kenhabbes-glitch/Varde/Varde-oppsett-ny-PC.docx

VARDE · PROSJEKT GPS VS TYV

# Oppsett på ny PC

Steg for steg: flytte prosjektet, installere programvare, kjøre plattformen lokalt og på Render, 3D-printe kapslingene og lage dokumentene på nytt. Oppdatert 27. oktober 2026. Skrevet for Windows 10 og 11.

# 1. Kort oppsummert

Alt du trenger ligger i Varde-prosjekt.zip. Dokumentene på claude.ai, Claude-prosjektet «GPS Vs Tyv», GitHub og Render følger kontoene dine og må ikke flyttes. Du trenger bare å logge inn på den nye PC-en.

1. Last ned Varde-prosjekt.zip og pakk den ut til C:\Varde.
2. Installer Node.js og eventuelt Python og et slicer-program (kapittel 4).
3. Åpne et terminalvindu i C:\Varde\Varde-prosjekt\kode og kjør npm test. Står det pass 23 og fail 0, er alt på plass.
4. Logg inn på claude.ai og åpne prosjektet «GPS Vs Tyv» for å fortsette arbeidet med Claude.

# 2. Innholdet i pakken

Mappen Varde-prosjekt inneholder dette:

Fil eller mappe | Innhold
LES-MEG.md | Oversikt over alle filene
GPS-Vs-Tyv-teknisk-design-v0.13.pdf | Gjeldende tekniske design, 54 sider
GPS-Vs-Tyv-elektriske-skjemaer-rev0.1.pdf | Elektriske skjemaer for alle kretskort (A3)
GPS-Vs-Tyv-simulator.html | Interaktiv demo av systemet. Åpnes i nettleser
GPS-Vs-Tyv-alarmsentral-prototype.html | Klikkbar prototype av dashboard og app
GPS-Vs-Tyv-designgrunnlag-hovedenhet-v1.docx | Første designgrunnlag. Delvis erstattet av PDF-en
kode\ | Plattform, dashboard, simulator og fastvare v0.2.1
kapslinger\ | STL-filer for 3D-print, bilder og kildekode v0.1
kilder\designdokument\ | Designdokumentet som HTML, og skript som lager PDF
kilder\skjemaer\ | Python-program som lager skjemaene
kilder\produktvisualisering\ | Kildefiler til produktvisualiseringen (referanse)
Varde-oppsett-ny-PC.docx | Denne veiledningen

Pakken inneholder ikke hemmeligheter. Plattformens nøkkel (platform-key.pem), lokale data (data.json) og tokenene til Render er holdt utenfor med vilje.

# 3. Flytte til ny PC

## Filene

1. Last ned Varde-prosjekt.zip fra Claude-samtalen.
2. Høyreklikk på filen, velg Pakk ut alle og velg C:\Varde som mål.
3. Ikke legg mappen i OneDrive. Synkroniseringen kan låse filer mens plattformen skriver til dem, og STL-filene er store.
4. Har du kjørt plattformen lokalt på den gamle PC-en og vil beholde testdataene, kopier data.json og platform-key.pem fra den gamle kodemappen til den nye. Ellers trenger du ikke dem.

## Claude-prosjektet og dokumentene

Prosjektet «GPS Vs Tyv» og alle dokumentene under ligger på claude.ai og følger kontoen din. Åpne dem fra nettleseren eller Claude-appen på den nye PC-en. Hvert dokument kan lastes ned som Word eller PDF fra dokumentets meny.

Dokument | Hva det er
Varde – oppsett av programvare (https://claude.ai/artifact/Y5VeZJ1YmCVUKAf8BAsJKU) | Den samme veiledningen som denne, i nettversjon
Varde – 3D-printede kapslinger (https://claude.ai/artifact/JtDKBCGQ6jCCAQ2TDHMq2U) | Materialer, innstillinger, montering og test av kapslingene
Varde – Adversarial Review (https://claude.ai/artifact/VaqWh7EG5VVC4pQoucCckC) | Gjennomgang av svakheter med prioritert tiltaksliste (engelsk)
Varde – produktvisualisering (https://claude.ai/artifact/XJEYnFzurU5y2nJ5eHvLHa) | Tavler med produktet, appen, geofence og navn og logo
GPS Vs Tyv – komponenter og leverandører (https://claude.ai/artifact/6AKMAZ8Rii6d945ZJGsUYA) | Komponentpriser, livsløp, CE og produsenter
GPS Vs Tyv-simulator (https://claude.ai/artifact/DBvJbYfc7tKbfaEAasuZXi) | Nettversjon av simulatoren
GPS Vs Tyv Alarmsentral (https://claude.ai/artifact/6chnuUW5rB7gucUFBs3AWz) | Nettversjon av alarmsentral-prototypen
Koplingsskjema og kretskortdesign v1 (https://claude.ai/artifact/FX7nrYhcUT3ShhFDbmn8so) | Første versjon av skjemaene (historikk)

## GitHub og Render

Har du allerede satt opp plattformen på Render, kjører den videre i skyen og trenger ikke flyttes. Logg inn på github.com og render.com på den nye PC-en. Tokenene finner du under Environment i Render-tjenesten. Har du ikke satt opp Render ennå, følg kapittel 6.

# 4. Installere programvare

Alt er gratis. Installer det du trenger for delen du skal jobbe med.

Program | Trengs for | Hent fra | Merknad
Node.js LTS (22.18 eller nyere) | Plattformen, simulatoren og å lage PDF-er | nodejs.org | Påkrevd for kode
Python 3.10 eller nyere | Endre mål på kapslinger, lage skjemaer | python.org (https://www.python.org/downloads/) | Huk av for «Add python.exe to PATH»
Bambu Studio eller PrusaSlicer | 3D-print | bambulab.com (https://bambulab.com/en/download/studio) / prusa3d.com (https://www.prusa3d.com/page/prusaslicer_424/) | Velg det som passer skriveren
Visual Studio Code | Lese og endre kode og mål | code.visualstudio.com | Valgfritt
GitHub Desktop | Laste opp endringer til GitHub | desktop.github.com | Valgfritt, enklere enn nettleseren
Claude-appen | Fortsette arbeidet med Claude | claude.ai/download | Valgfritt, nettleseren holder

Kontroller installasjonen i et nytt terminalvindu (trykk Windows-tasten, skriv cmd og trykk Enter):

node --version

npm --version

py --version

Node skal vise v22.18 eller høyere, og Python 3.10 eller høyere. Vises «gjenkjennes ikke», lukk vinduet og åpne et nytt.

# 5. Plattformen på din PC

Kjør plattformen lokalt først. Da ser du dashboardet og alarmene uten kostnad, og du vet at alt virker før det legges på nett.

1. Åpne mappen C:\Varde\Varde-prosjekt\kode i Filutforsker, skriv cmd i adressefeltet og trykk Enter.
2. Kjør testene med npm test. Nederst skal det stå pass 23 og fail 0. Det trengs ingen npm install, fordi koden ikke har tilleggspakker.
3. Start plattformen med npm run dev. Svaret er Varde-plattformen kjører på http://localhost:8080 (UTVIKLINGSMODUS ...). La vinduet stå åpent.
4. Gå til http://localhost:8080 i nettleseren. Skriv operator-dev i Token-feltet og trykk Kople til.
5. Åpne et nytt terminalvindu i samme mappe og kjør npm run sim:auto. Simulatoren spiller av åtte scenarioer, og til slutt står det Alle kontroller bestått. Alarmene vises i dashboardet underveis.
6. Kjør npm run sim for den interaktive simulatoren. Skriv hjelp for å se kommandoene.
7. Stopp med Ctrl+C i begge vinduene.

Utviklingsmodus bruker de faste tokenene admin-dev og operator-dev og er bare for din egen PC. npm start (driftsmodus) starter ikke uten egne token.

## Fastvaretester (valgfritt)

Fastvaretestene trenger en C-kompilator. Den enkleste veien på Windows er WSL med Ubuntu: kjør wsl --install i PowerShell som administrator, start PC-en på nytt, og kjør deretter sudo apt install build-essential i Ubuntu. Gå til kodemappen (cd /mnt/c/Varde/Varde-prosjekt/kode) og kjør make -C firmware/hovedenhet/test. Det skal stå 198 av 198 kontroller bestått.

# 6. Plattformen på nett (Render)

Plattformen må kjøre hele tiden, ellers merker den ikke at en maskin har blitt stille. Gratisvarianten hos Render sover etter 15 minutter uten trafikk og kan ikke ha disk, så den passer ikke. Velg instanstypen Starter med disk. Den koster rundt 7 USD i måneden, og disken 0,25 USD per GB i måneden. Sjekk gjeldende pris på render.com.

## Legg koden på GitHub

1. Logg inn på github.com og velg New repository. Gi det navnet varde og velg Private.
2. Velg uploading an existing file og dra inn alt innholdet i mappen kode, også mappen .github. Med GitHub Desktop: velg Add existing repository, pek på kodemappen og trykk Publish repository med Keep this code private på.
3. Ikke last opp data.json eller platform-key.pem hvis de finnes.
4. Trykk Commit changes. Under fanen Actions kjører testene automatisk og skal bli grønne.

## Opprett tjenesten hos Render

1. Logg inn på render.com med GitHub-kontoen og velg New → Web Service. Gi Render tilgang til repoet varde og velg det.
2. Velg Language: Docker, region Frankfurt (EU Central) og instanstype Starter.
3. Under Environment Variables legger du inn GVT_ADMIN_TOKEN og GVT_OPERATOR_TOKEN. Trykk Generate for hver av dem. Plattformen starter ikke uten dem, og de må være minst 32 tegn.
4. Under Advanced → Disk velger du Add disk med mount path /data og størrelse 1 GB.
5. Sett Health Check Path til /api/health.
6. Trykk Deploy Web Service. Etter et par minutter skal loggen vise Varde-plattformen kjører på ....

## Test at den virker

1. Åpne adressen Render viser, for eksempel https://varde-xxxx.onrender.com.
2. Kopier verdien av GVT_OPERATOR_TOKEN fra Render, lim den inn i Token-feltet og trykk Kople til.
3. Kjør simulatoren mot nettversjonen fra kodemappen, med dine egne verdier:

set GVT_URL=https://varde-xxxx.onrender.com

set GVT_ADMIN_TOKEN=<admin-token fra Render>

set GVT_OPERATOR_TOKEN=<operatør-token fra Render>

npm run sim:auto

I PowerShell skrives det $env:GVT_URL="https://..." i stedet for set. Nye versjoner rulles ut automatisk når du laster opp endringer til GitHub. Del bare operatør-tokenet med dem som skal følge alarmene.

# 7. 3D-print og nye dokumenter

## Printe kapslingene

1. Åpne Bambu Studio eller PrusaSlicer og velg skrivermodellen.
2. Dra en STL-fil fra kapslinger\stl inn i programmet, for eksempel varde-hovedenhet-bunn-prototype.stl. Delen ligger allerede riktig vei.
3. Velg PETG for prototype og ASA for felt. Bruk innstillingene i dokumentet «Varde – 3D-printede kapslinger»: 0,2 mm lag, 3 vegger og 25 % gyroid (PETG), eller 5 vegger og 40 % gyroid (ASA). Ingen støtte.
4. Trykk Slice, kontroller lagene og print. Print bunn og lokk av hovedenheten i PETG først for å teste passform.
5. Uten egen skriver: bestill feltvarianten i SLS PA12, svart, med impregnering hos et printverksted.

## Endre mål og lage nye STL-filer

Åpne et terminalvindu i kapslinger\kilde. Endre mål i varde_kapsling.py (søk etter SJEKK), og lag filene på nytt:

py varde_kapsling.py

py varde_kapsling.py hovedenhet

py meshcheck.py stl\*.stl

Den første kommandoen lager alle enhetene og den andre bare én. Den tredje kontrollerer filene: tallet i midten skal være 0. Nye filer havner i kapslinger\kilde\stl.

## Lage designdokumentet og skjemaene på nytt

Dette trengs bare hvis du endrer kildefilene. Begge bruker nettleseren Chromium via Playwright, som installeres én gang i mappen kilder:

cd C:\Varde\Varde-prosjekt\kilder

npm init -y

npm install playwright

npx playwright install chromium

Designdokumentet: endre designdokument\design.html og kjør node lag-pdf.js i den mappen. Resultatet blir out.pdf.

Skjemaene: kjør py build.py i skjemaer. Det lager schem.html og skriver ut eventuelle nett med bare én tilkobling, som er forventet for ubrukte innganger. Kjør så node pdf.js for å lage schem.pdf.

Produktvisualiseringen redigeres på claude.ai. Filene i kilder\produktvisualisering er en sikkerhetskopi av tavlene.

# 8. Feilsøking

Melding eller symptom | Årsak | Løsning
Unknown file extension ".ts" | Node er eldre enn 22.18 | Installer siste LTS og åpne et nytt terminalvindu
npm eller py gjenkjennes ikke | Programmet er ikke i PATH | Åpne nytt vindu. Hjelper ikke det, installer på nytt med PATH-valget på
GVT_ADMIN_TOKEN og GVT_OPERATOR_TOKEN må settes | Startet med npm start uten token | Lokalt: npm run dev. På Render: legg inn begge variablene
Token må være minst 32 tegn | For kort token eller utviklingsverdi | Bruk Generate hos Render
EADDRINUSE | Port 8080 er i bruk | Lukk det andre vinduet, eller set PORT=8081 før npm run dev
Mangler eller ugyldig token i dashboardet | Feil token i feltet | Lokalt operator-dev, på nett verdien fra Render
Simulatoren får 401 mot Render | set-verdiene mangler eller er feil | Sett de tre verdiene på nytt i samme vindu
EACCES på /data i Render-loggen | Disken er ikke skrivbar | Kontroller mount path /data. Spør Claude om å justere Dockerfile
Røde tester i GitHub Actions | Feil i koden eller manglende fil | Åpne kjøringen og les siste feilmelding
Sliceren varsler om «non-manifold» | Fil endret eller lagret på nytt | Lag filen på nytt og kontroller med meshcheck.py
Cannot find module 'playwright' | Playwright er ikke installert i kilder | Kjør kommandoene i kapittel 7 på nytt

# 9. Status og neste steg

Prosjektet er et grunnlag for anbud: konsept, teknisk design, skjemaer, prototypekode og kapslinger for testing. Ingenting er testet på ekte maskinvare ennå. De viktigste tiltakene fra gjennomgangen, i prioritert rekkefølge:

# | Tiltak | Status

1 | Ta imot meldinger lagret under jamming (vindu for teller i stedet for strengt høyeste verdi) | Åpent
2 | Token kreves i drift, ingen standardverdier | Gjort i v0.2.1. Innlogging (OIDC) og kunder er åpent
3 | Ekte varsling (push, SMS, tale), gjentatt eskalering og avtale med alarmstasjon | Åpent
4 | Sabotasjesløyfer som oppdager brudd, kortslutning og brokobling, og som kan vekke enheten | Åpent, endrer skjemaene
5 | Jamming som egen hendelse, samlet per anlegg, og test av LoRa-relé under jamming | Åpent
6 | Fastvaren sender riktig alarmmodus og armeringsstatus | Gjort i v0.2.1. Sending ved endring og sirenetid er åpent
7 | Telleren i sikkerhetsbrikken må vare hele levetiden | Åpent
8 | Drift med to instanser, database, overvåking og nøkkel i Key Vault | Åpent
9–14 | Validering av meldinger, gjenåpning av saker, læremodus, CE/RED og GDPR, krav i anbudet, leveringssikkerhet | Åpent
– | Brikke S blir ca. 19 mm høy (ER14250 er 14,5 mm). Rett designdokumentet eller velg flatere batteri | Åpent

Fullstendig liste med begrunnelse står i «Varde – Adversarial Review». For å fortsette med Claude: åpne prosjektet «GPS Vs Tyv» og skriv hva du vil gjøre, for eksempel «fiks punkt 1 i gjennomgangen».

Varde – oppsett på ny PC · side
