kenhabbes-glitch/Varde/kapslinger/bilder/brikke-l-felt.png

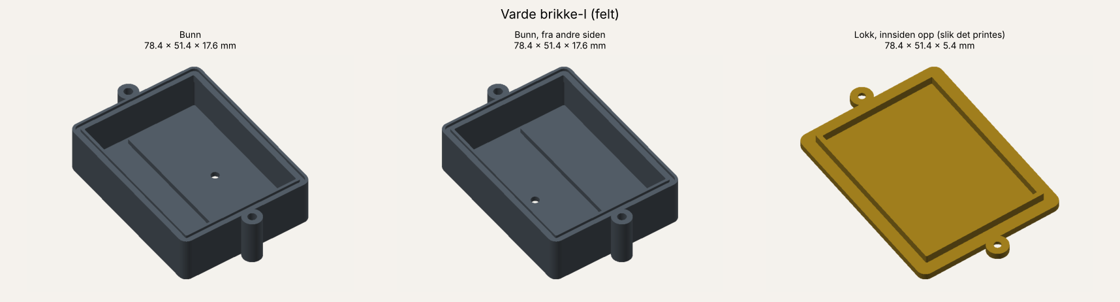
kapslinger/bilder/brikke-l-felt.png
