kenhabbes-glitch/Varde/kapslinger/bilder/brikke-s-felt.png

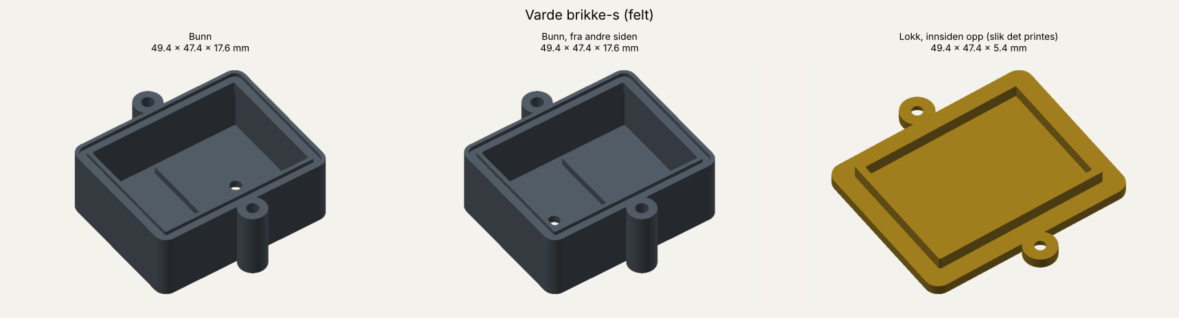
kapslinger/bilder/brikke-s-felt.png
