kenhabbes-glitch/Varde/kapslinger/bilder/kamerapod-felt.png

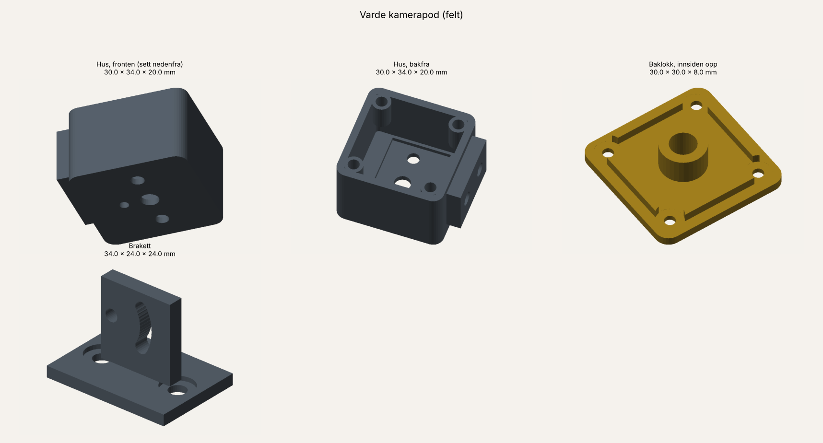
kapslinger/bilder/kamerapod-felt.png
