kenhabbes-glitch/Varde/kapslinger/stl/varde-brikke-s-lokk-felt.stl

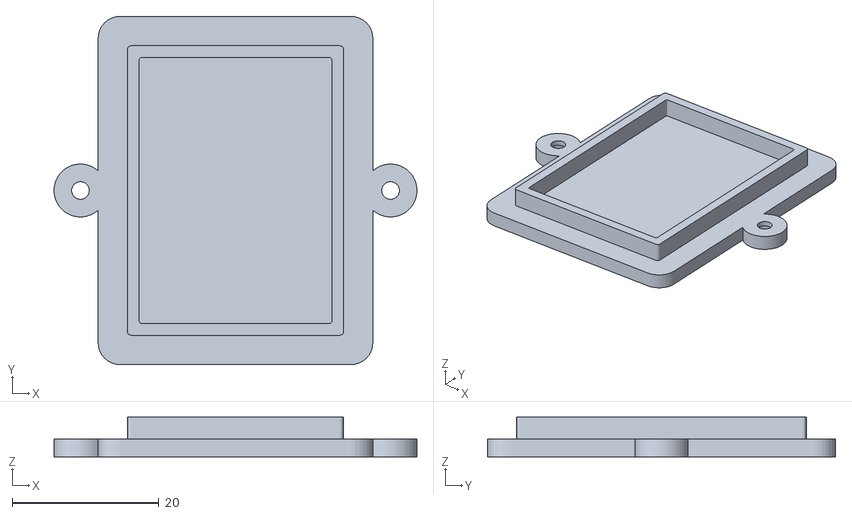
[picture p20: CAD file, 2026-10-27]
kapslinger/stl/varde-brikke-s-lokk-felt.stl
49.4 x 47.4 x 5.40
