kenhabbes-glitch/Varde/kapslinger/stl/varde-hovedenhet-lokk-prototype.stl

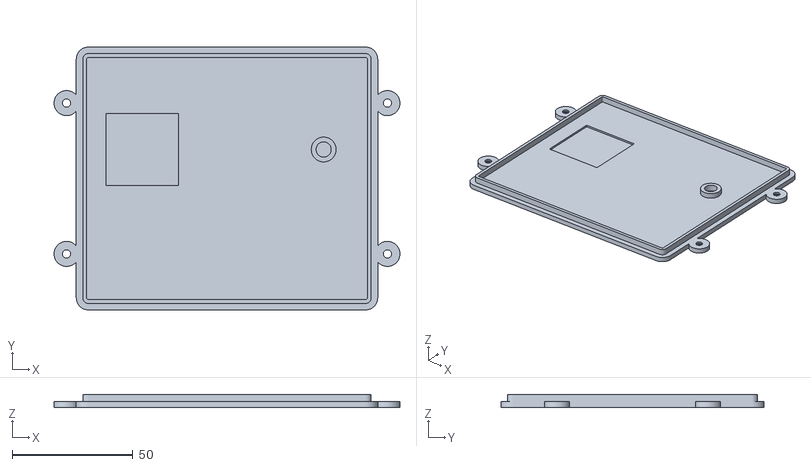
[picture p21: CAD file, 2026-10-27]
kapslinger/stl/varde-hovedenhet-lokk-prototype.stl
143.2 x 108.8 x 5.40
