kenhabbes-glitch/Varde/kapslinger/stl/varde-utvidelsesboks-bunn-felt.stl

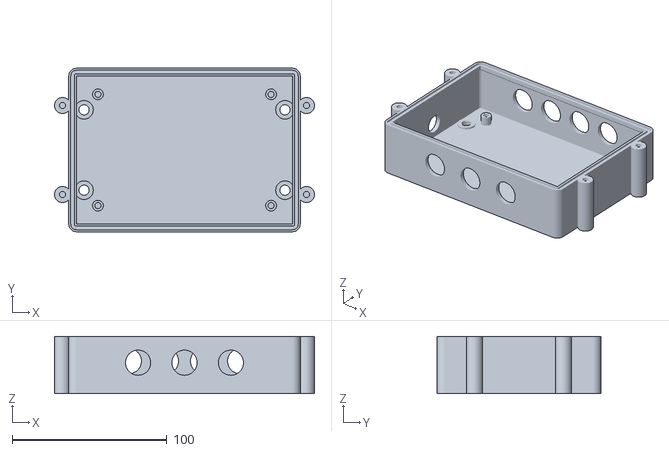
[picture p22: CAD file, 2026-10-27]
kapslinger/stl/varde-utvidelsesboks-bunn-felt.stl
168.2 x 105.8 x 37.0
