kenhabbes-glitch/Varde/kapslinger/stl/varde-utvidelsesboks-lokk-prototype.stl

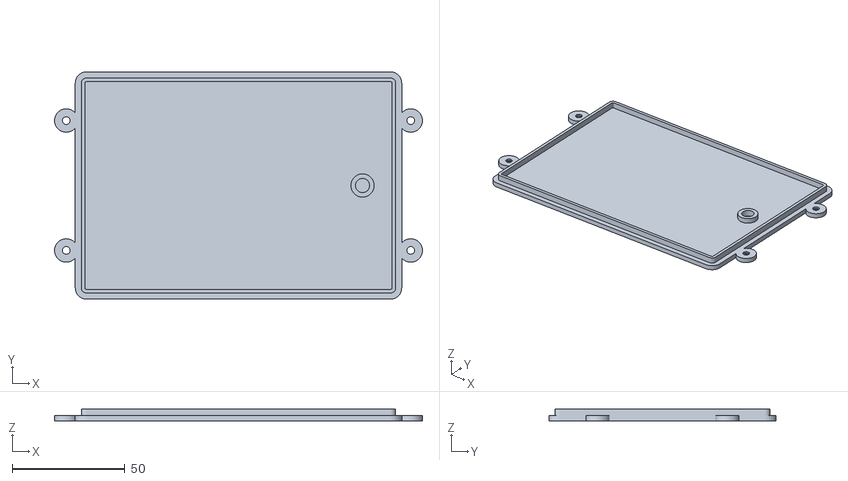
[picture p23: CAD file, 2026-10-27]
kapslinger/stl/varde-utvidelsesboks-lokk-prototype.stl
163.2 x 100.8 x 5.40
