kenhabbes-glitch/Varde/kapslinger/stl/varde-kamerapod-baklokk-prototype.stl

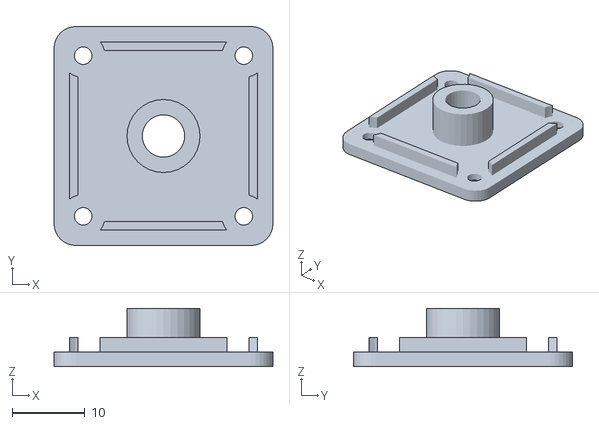
[picture p24: CAD file, 2026-10-27]
kapslinger/stl/varde-kamerapod-baklokk-prototype.stl
30.0 x 30.0 x 8.00
