kenhabbes-glitch/Varde/kapslinger/stl/varde-brikke-s-bunn-felt.stl

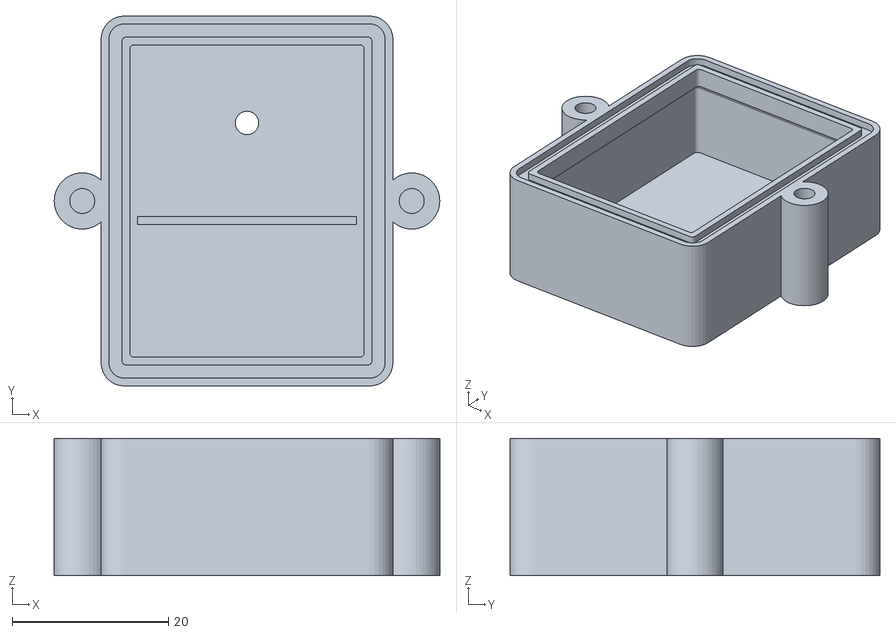
[picture p25: CAD file, 2026-10-27]
kapslinger/stl/varde-brikke-s-bunn-felt.stl
49.4 x 47.4 x 17.6
