kenhabbes-glitch/Varde/kapslinger/stl/varde-hovedenhet-bunn-prototype.stl

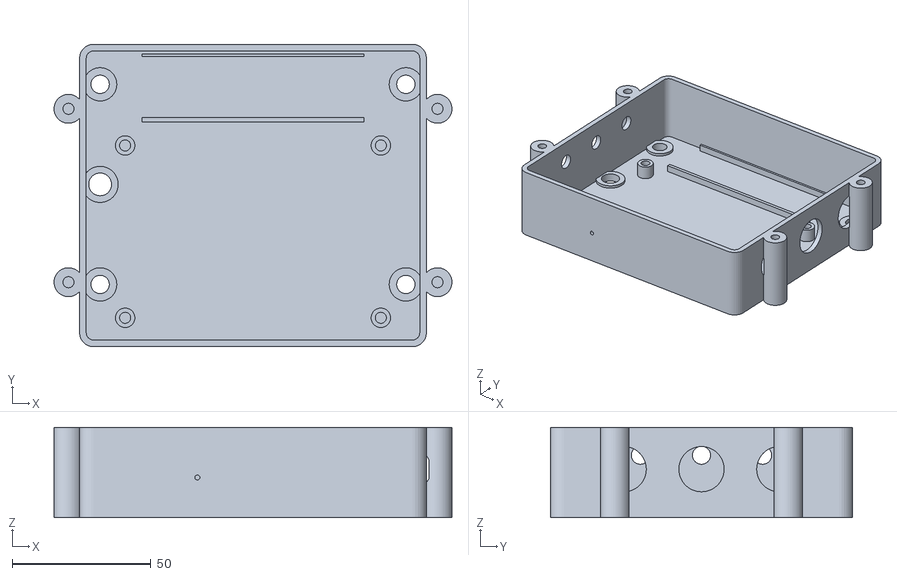
[picture p26: CAD file, 2026-10-27]
kapslinger/stl/varde-hovedenhet-bunn-prototype.stl
143.2 x 108.8 x 32.4
