kenhabbes-glitch/Varde/kapslinger/stl/varde-sensornode-lokk-felt.stl

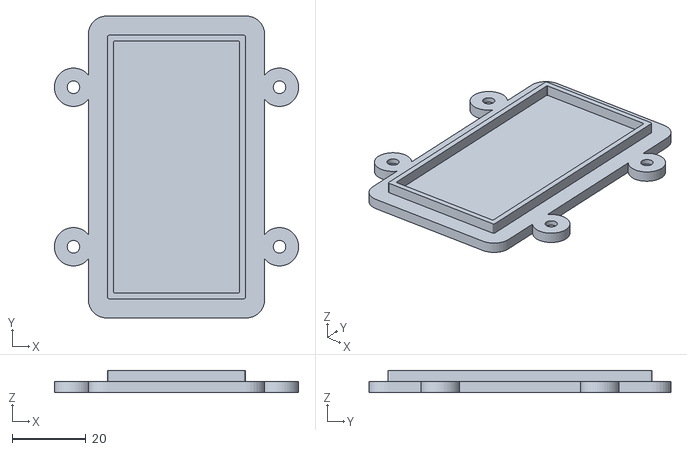
[picture p27: CAD file, 2026-10-27]
kapslinger/stl/varde-sensornode-lokk-felt.stl
66.2 x 81.8 x 6.00
