kenhabbes-glitch/Varde/kapslinger/stl/varde-hovedenhet-bunn-felt.stl

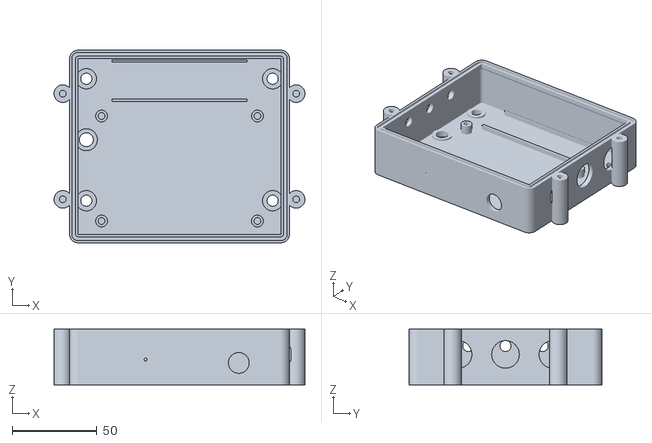
[picture p28: CAD file, 2026-10-27]
kapslinger/stl/varde-hovedenhet-bunn-felt.stl
148.2 x 113.8 x 33.0
