kenhabbes-glitch/Varde/kapslinger/stl/varde-sensornode-bunn-prototype.stl

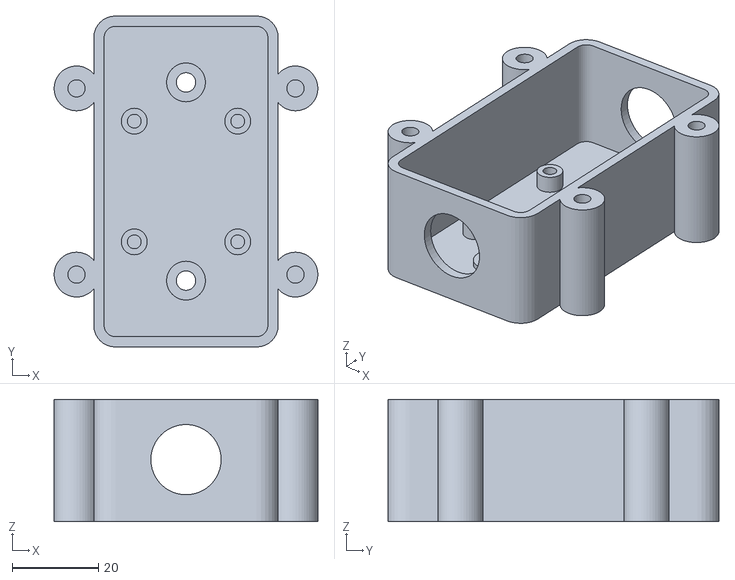
[picture p29: CAD file, 2026-10-27]
kapslinger/stl/varde-sensornode-bunn-prototype.stl
61.2 x 76.8 x 28.4
