kenhabbes-glitch/Varde/kapslinger/stl/varde-brikke-l-lokk-prototype.stl

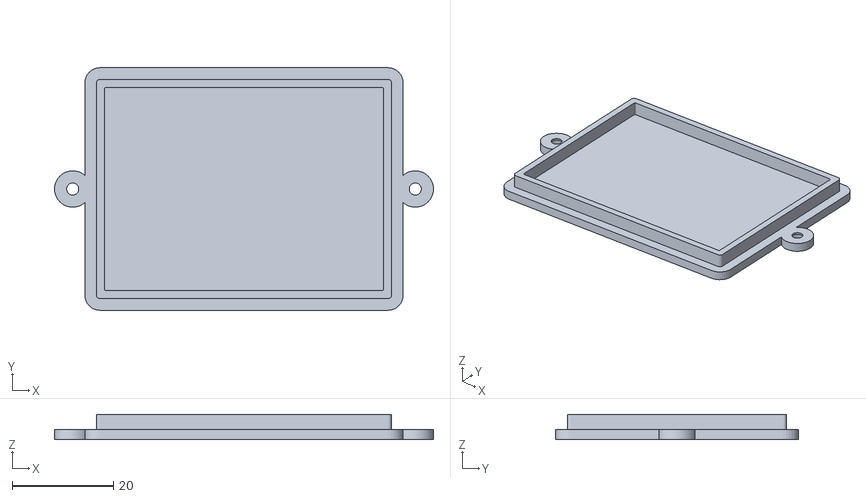
[picture p30: CAD file, 2026-10-27]
kapslinger/stl/varde-brikke-l-lokk-prototype.stl
75.0 x 48.0 x 5.00
