kenhabbes-glitch/Varde/kapslinger/stl/varde-brikke-l-bunn-felt.stl

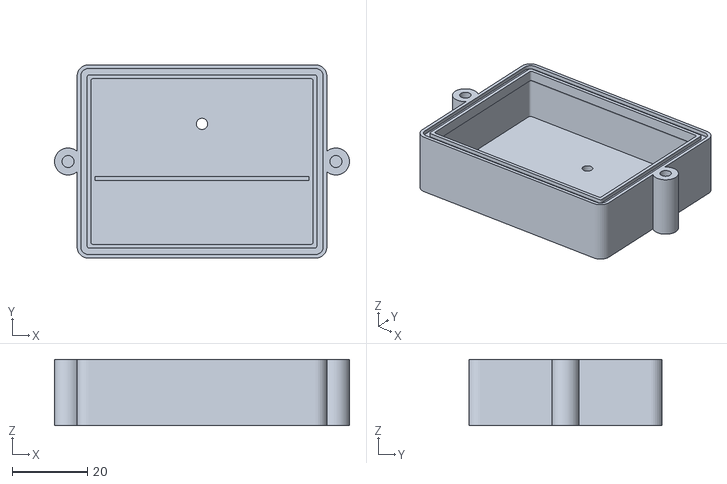
[picture p31: CAD file, 2026-10-27]
kapslinger/stl/varde-brikke-l-bunn-felt.stl
78.4 x 51.4 x 17.6
