kenhabbes-glitch/Varde/kapslinger/stl/varde-sensornode-lokk-prototype.stl

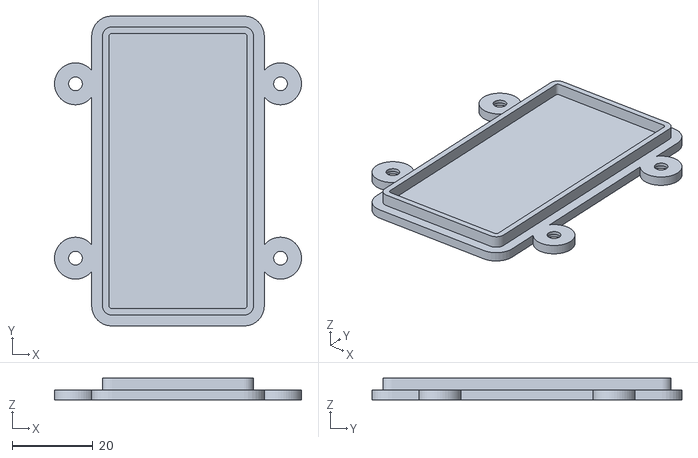
[picture p32: CAD file, 2026-10-27]
kapslinger/stl/varde-sensornode-lokk-prototype.stl
61.2 x 76.8 x 5.40
