kenhabbes-glitch/Varde/kapslinger/stl/varde-kamerapod-hus-felt.stl

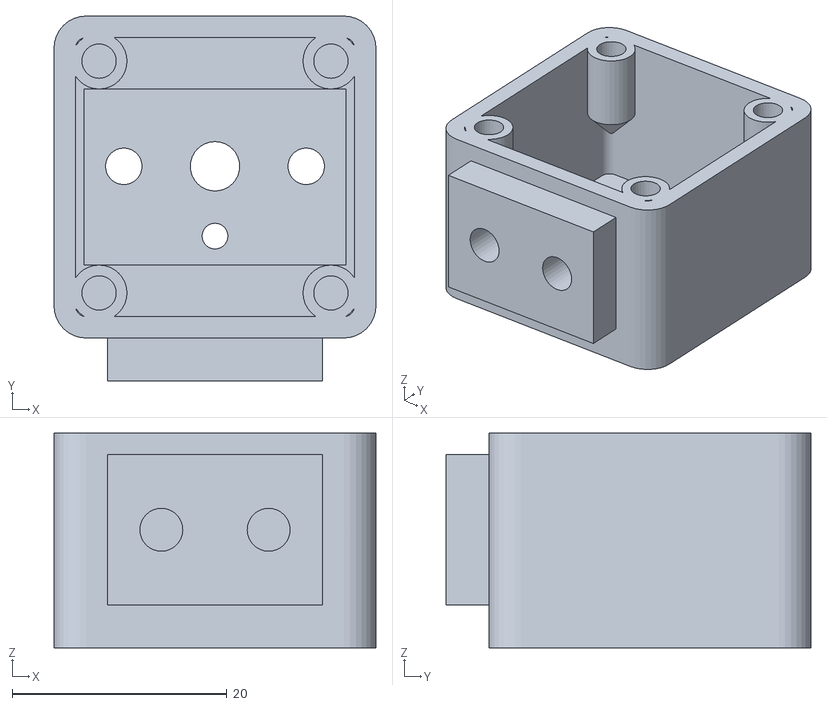
[picture p33: CAD file, 2026-10-27]
kapslinger/stl/varde-kamerapod-hus-felt.stl
30.0 x 34.0 x 20.0
