kenhabbes-glitch/Varde/kapslinger/stl/varde-kamerapod-brakett-felt.stl

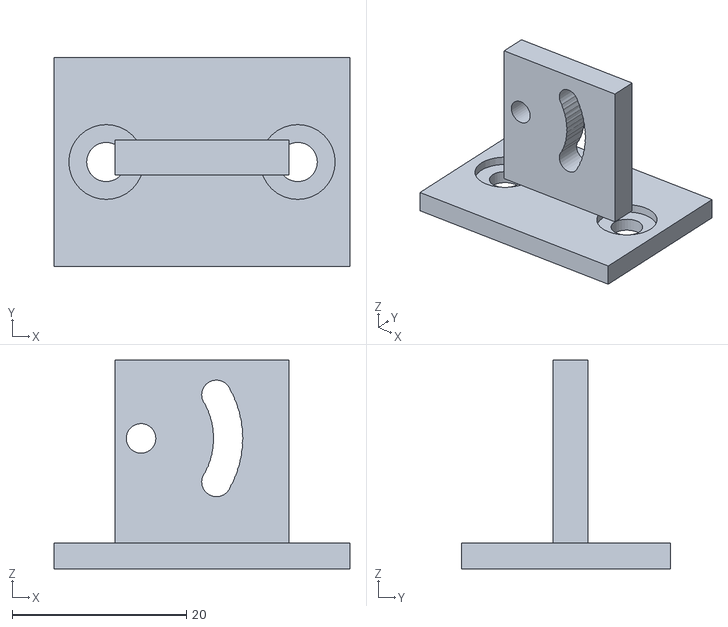
[picture p34: CAD file, 2026-10-27]
kapslinger/stl/varde-kamerapod-brakett-felt.stl
34.0 x 24.0 x 24.0
