kenhabbes-glitch/Varde/kapslinger/stl/varde-brikke-l-lokk-felt.stl

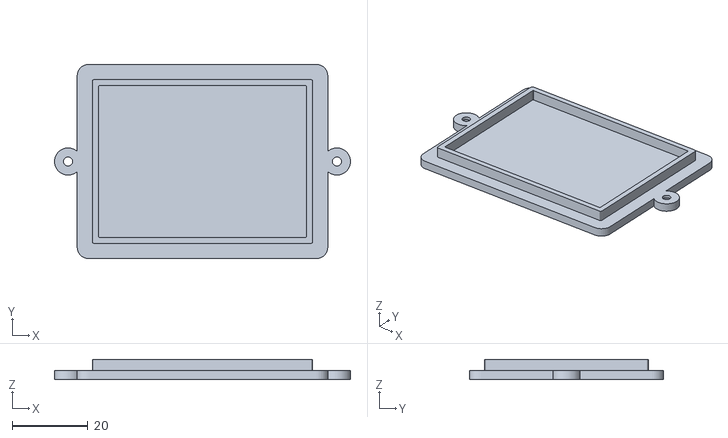
[picture p35: CAD file, 2026-10-27]
kapslinger/stl/varde-brikke-l-lokk-felt.stl
78.4 x 51.4 x 5.40
