kenhabbes-glitch/Varde/kapslinger/stl/varde-brikke-l-bunn-prototype.stl

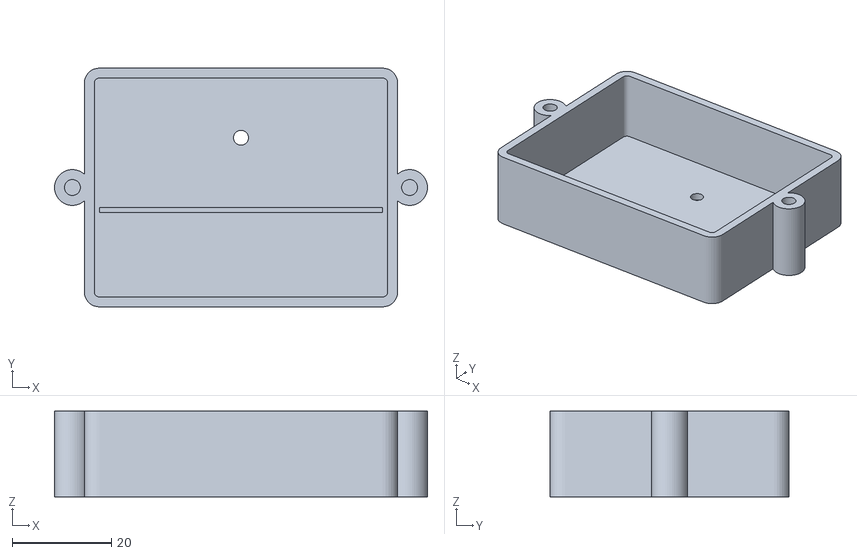
[picture p36: CAD file, 2026-10-27]
kapslinger/stl/varde-brikke-l-bunn-prototype.stl
75.0 x 48.0 x 17.2
