kenhabbes-glitch/Varde/kapslinger/stl/varde-sensornode-bunn-felt.stl

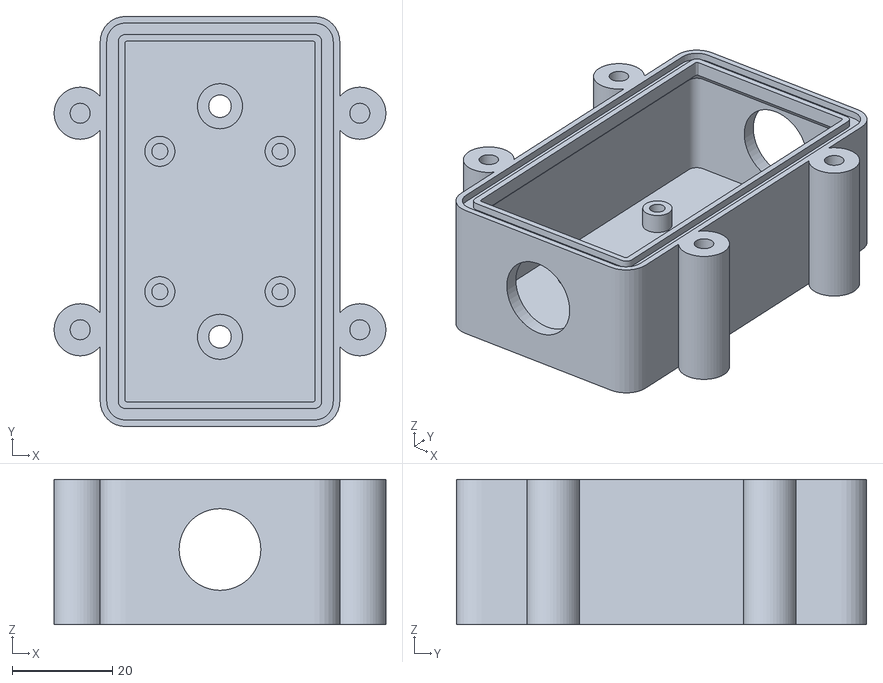
[picture p37: CAD file, 2026-10-27]
kapslinger/stl/varde-sensornode-bunn-felt.stl
66.2 x 81.8 x 29.0
