kenhabbes-glitch/Varde/kapslinger/stl/varde-brikke-s-bunn-prototype.stl

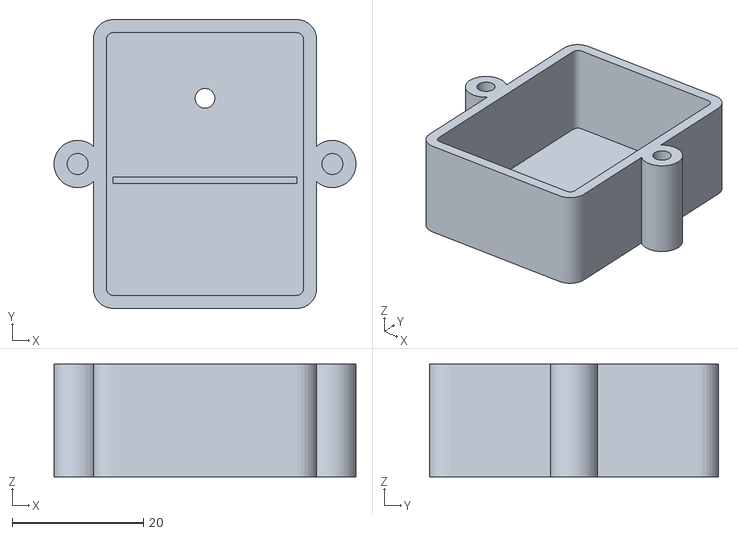
[picture p38: CAD file, 2026-10-27]
kapslinger/stl/varde-brikke-s-bunn-prototype.stl
46.0 x 44.0 x 17.2
