kenhabbes-glitch/Varde/kapslinger/stl/varde-utvidelsesboks-bunn-prototype.stl

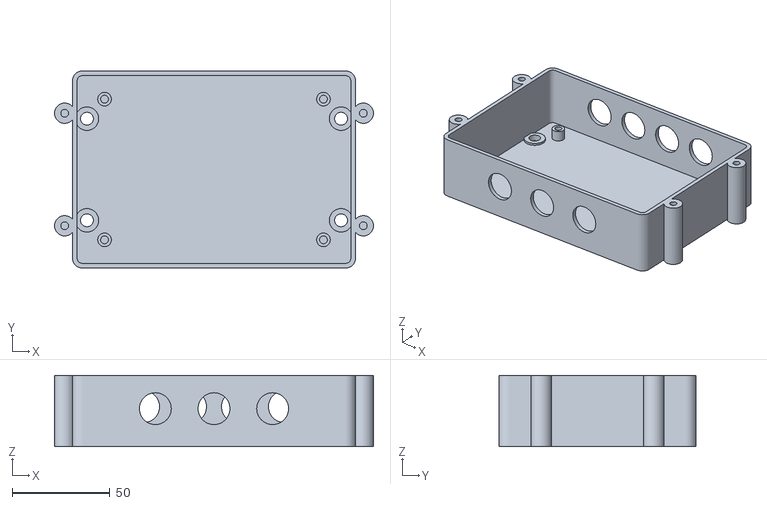
[picture p39: CAD file, 2026-10-27]
kapslinger/stl/varde-utvidelsesboks-bunn-prototype.stl
163.2 x 100.8 x 36.4
