kenhabbes-glitch/Varde/kapslinger/stl/varde-utvidelsesboks-lokk-felt.stl

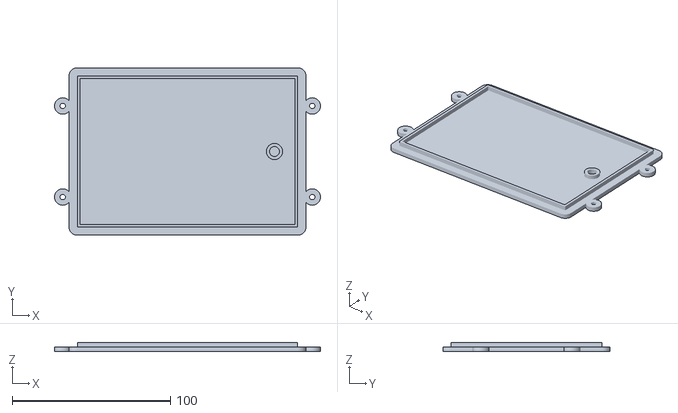
[picture p40: CAD file, 2026-10-27]
kapslinger/stl/varde-utvidelsesboks-lokk-felt.stl
168.2 x 105.8 x 6.00
