kenhabbes-glitch/Varde/kapslinger/stl/varde-hovedenhet-lokk-felt.stl

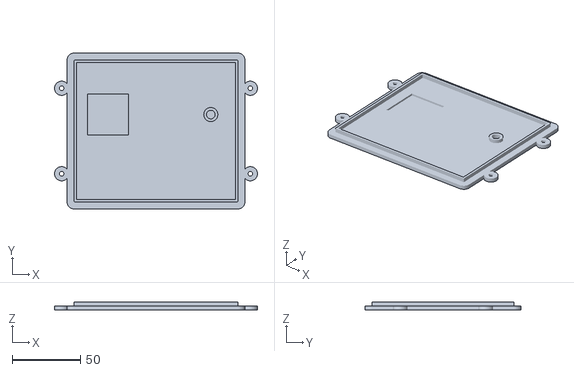
[picture p41: CAD file, 2026-10-27]
kapslinger/stl/varde-hovedenhet-lokk-felt.stl
148.2 x 113.8 x 6.00
