kenhabbes-glitch/Varde/kapslinger/stl/varde-brikke-s-lokk-prototype.stl

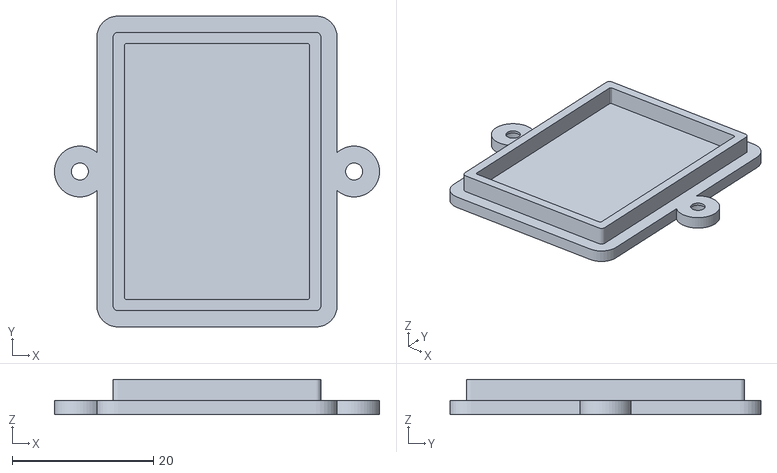
[picture p42: CAD file, 2026-10-27]
kapslinger/stl/varde-brikke-s-lokk-prototype.stl
46.0 x 44.0 x 5.00
