kenhabbes-glitch/Varde/(list of files, cad)

Other CAD files:
kapslinger/stl/varde-kamerapod-baklokk-felt.stl
kapslinger/stl/varde-kamerapod-hus-prototype.stl
kapslinger/stl/varde-kamerapod-brakett-prototype.stl
